Jcouronne/Plateforme_de_mesure/README.md

Fonctionnement : <br />
1-Acquisition des mesures capteurs par l'arduino (.ino) et envoi sur le port série <br />
2-Lecture des mesures via le port série et calibration sur le pc. <br />
<br />
! Attention, la calibration reste à effectuer. Si vous souhaitez visualiser les valeurs supprimez le fichier calibration.json
