Jcouronne/Plateforme_de_mesure/(commit log)

2026-02-26 Add calibration warning to README
    Added a warning about calibration and visualizing values.
2026-03-02 Rapport de fin de projet
